brianthornock/DiSH/(commit log)

2019-03-28 Gerber layout files for 125B enclosure added.
2019-03-28 MCU Source Code Attached
2019-04-01 Updated silkscreen on Gerber Files
2019-04-02 Gerber file clean up
2019-07-14 updated to work correctly
    Updated with new ATTiny85 pinout
    Pulldown resistor on tap switch
    Fixed -VCC routing
    Rearranged for use of Pin B5 as analog in
2019-07-14 Code for Rev 1.1 PCB
2019-07-14 Delete TheDiSH.zip
    Removing rev 1.0 PCB with errors
2020-05-03 Updated to fit in 125B Enclosure
